thomasquinn93/gps-drifters/3D Models/Drifter Enclosure - SD Card Holder.stl

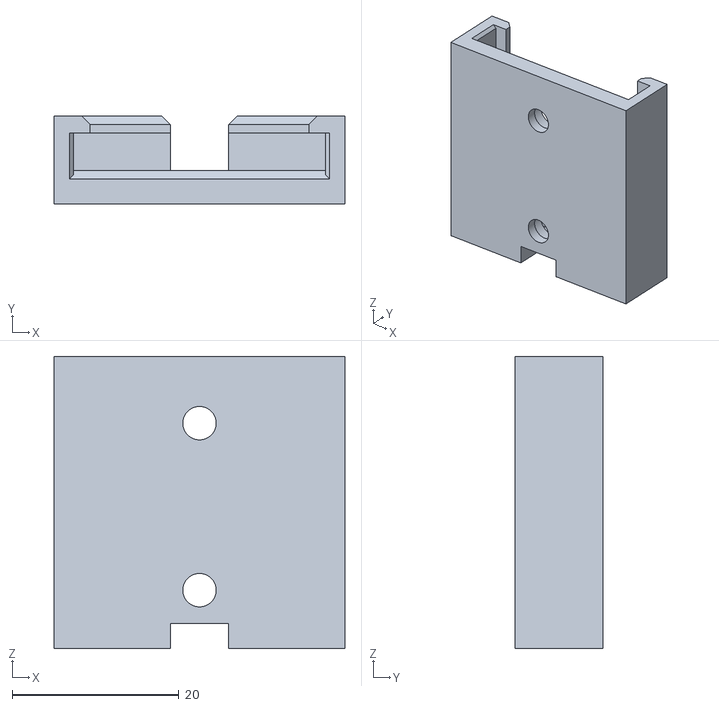
[picture p1: CAD file, 2018-05-13]
3D Models/Drifter Enclosure - SD Card Holder.stl
34.9 x 10.5 x 35.0
