thomasquinn93/gps-drifters/3D Models/Drifter Enclosure - o-ring.stl

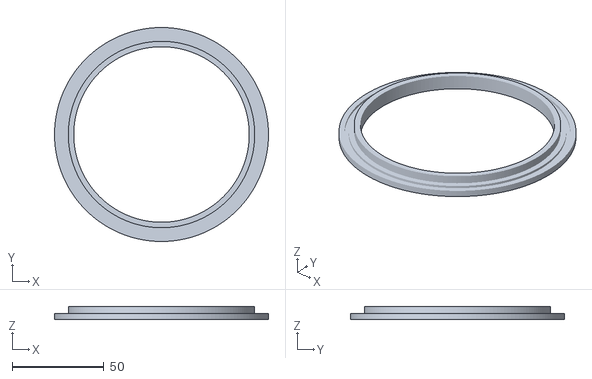
[picture p2: CAD file, 2018-05-13]
3D Models/Drifter Enclosure - o-ring.stl
116.9 x 116.9 x 7.25
