thomasquinn93/gps-drifters/3D Models/Drifter Enclosure - Bottom Left Wing.stl

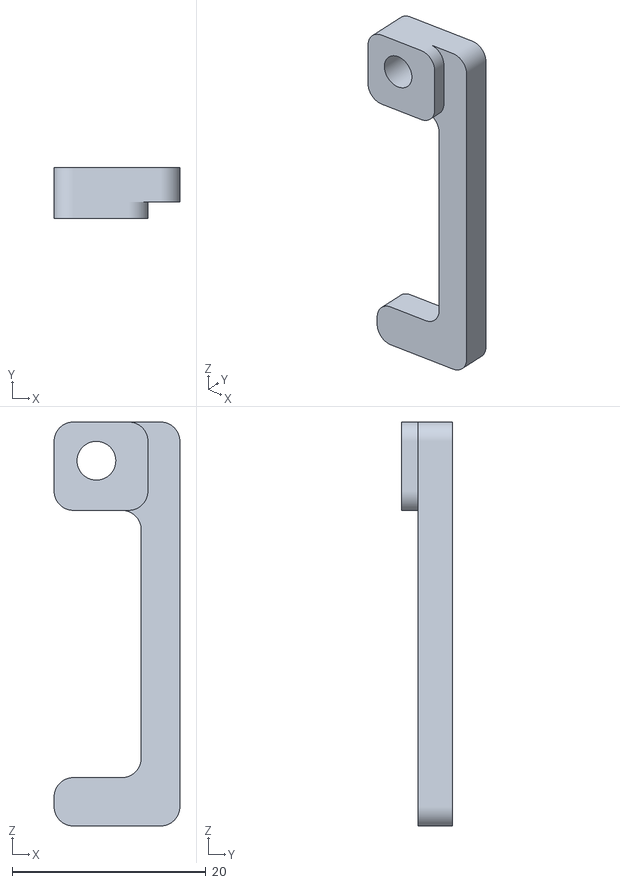
[picture p3: CAD file, 2018-05-13]
3D Models/Drifter Enclosure - Bottom Left Wing.stl
13.0 x 5.30 x 41.7
