thomasquinn93/gps-drifters/3D Models/Drifter Enclosure - Cradle.stl

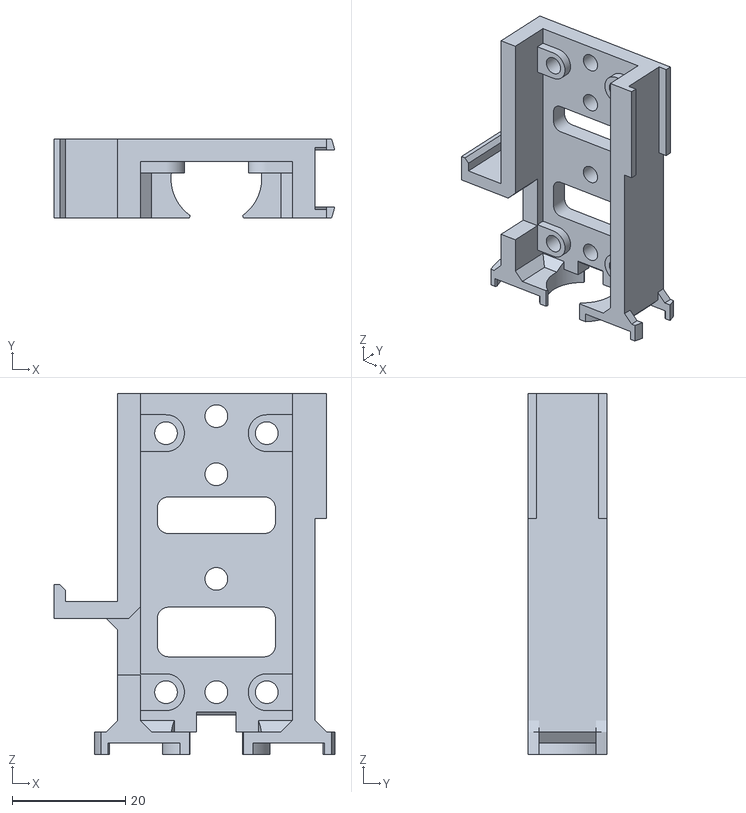
[picture p4: CAD file, 2018-05-13]
3D Models/Drifter Enclosure - Cradle.stl
49.5 x 14.0 x 63.7
