thomasquinn93/gps-drifters/3D Models/Drifter Enclosure - Base.stl

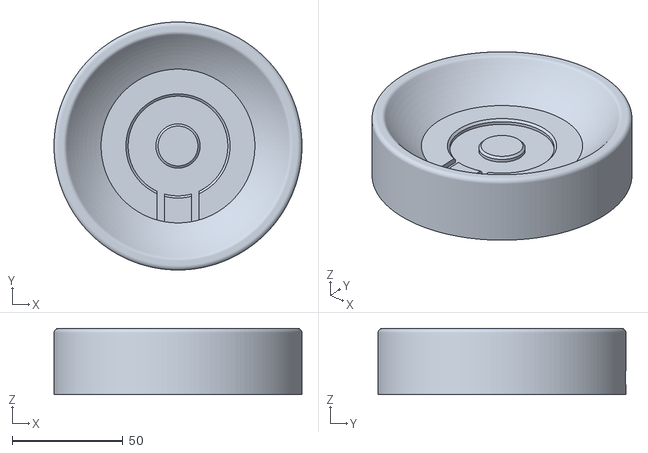
[picture p5: CAD file, 2018-05-13]
3D Models/Drifter Enclosure - Base.stl
112.0 x 112.0 x 29.9
