thomasquinn93/gps-drifters/3D Models/Drifter Enclosure - Shell Bottom.stl

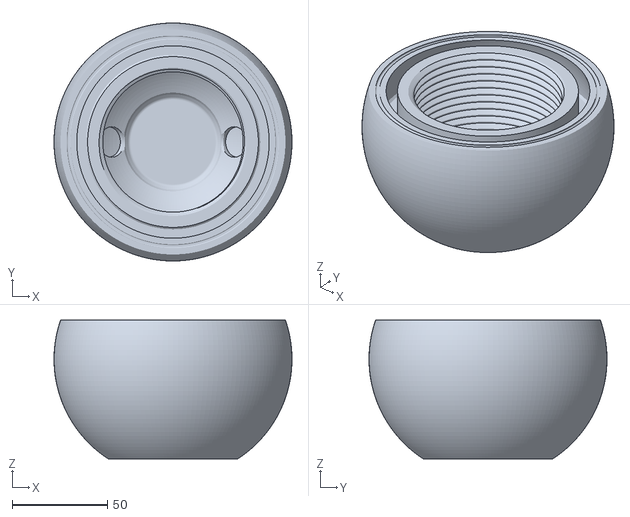
[picture p6: CAD file, 2018-05-13]
3D Models/Drifter Enclosure - Shell Bottom.stl
124.8 x 124.8 x 72.7
