thomasquinn93/gps-drifters/3D Models/Drifter Enclosure - Shell Top.stl

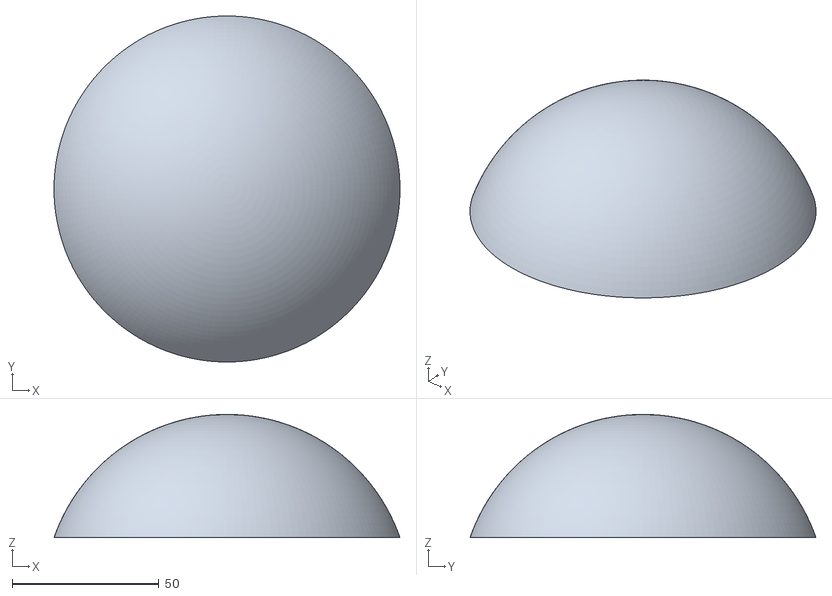
[picture p7: CAD file, 2018-05-13]
3D Models/Drifter Enclosure - Shell Top.stl
117.9 x 117.9 x 42.0
