thomasquinn93/gps-drifters/3D Models/Drifter Enclosure - Wing Connector.stl

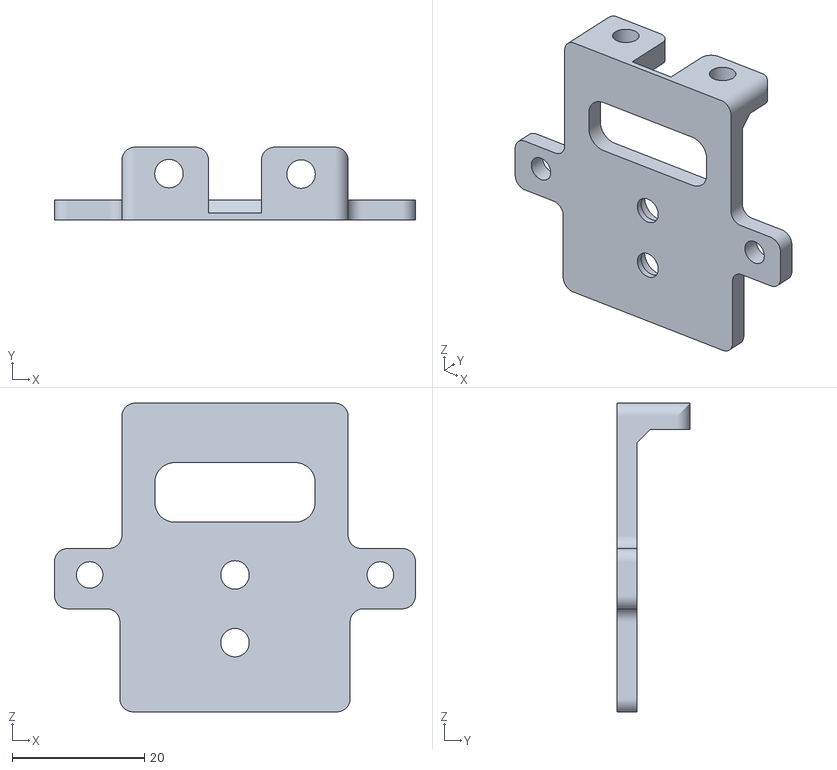
[picture p8: CAD file, 2018-05-13]
3D Models/Drifter Enclosure - Wing Connector.stl
54.6 x 11.0 x 46.7
