thomasquinn93/gps-drifters/3D Models/Drifter Enclosure - Shelf.stl

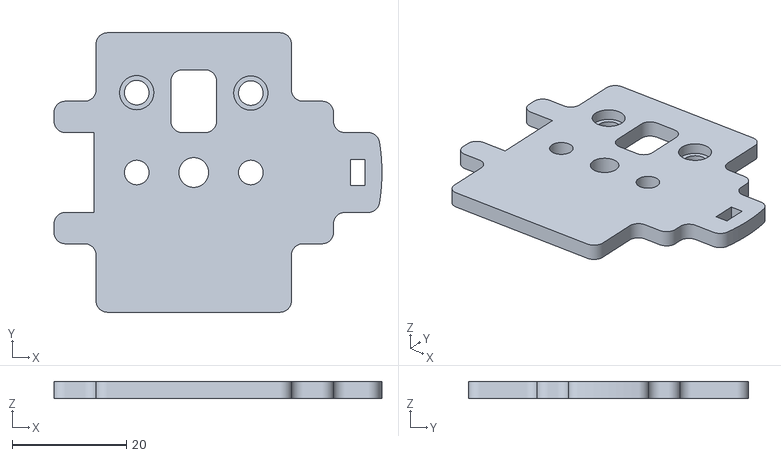
[picture p9: CAD file, 2018-05-13]
3D Models/Drifter Enclosure - Shelf.stl
57.5 x 49.0 x 3.00
