thomasquinn93/gps-drifters/3D Models/Drifter Enclosure - Core.stl

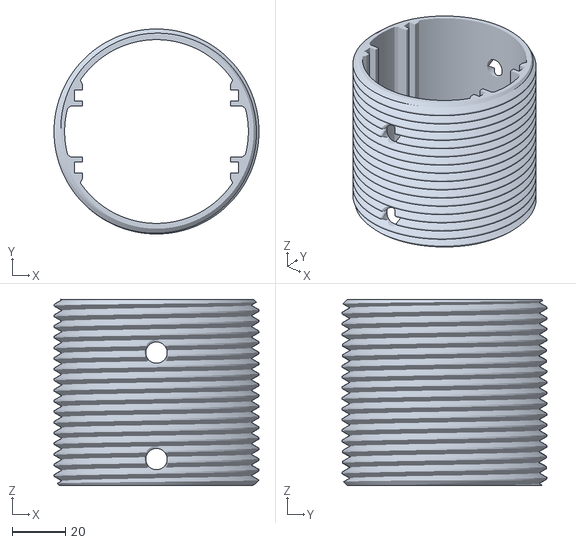
[picture p10: CAD file, 2018-05-13]
3D Models/Drifter Enclosure - Core.stl
77.0 x 77.0 x 70.0
