thomasquinn93/gps-drifters/(list of files, cad)

Other CAD files:
3D Models/Drifter Enclosure - Bottom Right Wing.stl
