thomasquinn93/gps-drifters/ultimateGPS-featherwing-test/ultimateGPS-featherwing-test.ino

// test a passthru between USB and hardware serial

#if defined(ARDUINO_SAMD_ZERO) && defined(SERIAL_PORT_USBVIRTUAL)
  // Required for Serial on Zero based boards
  #define Serial SERIAL_PORT_USBVIRTUAL
#endif

void setup() {
  Serial.println("GPS echo test");
  Serial.begin(9600);
  Serial1.begin(9600);      // default NMEA GPS baud
}


void loop() {
  if (Serial.available()) {
    char c = Serial.read();
    Serial1.write(c);
  }
  if (Serial1.available()) {
    char c = Serial1.read();
    Serial.write(c);
  }
}
