thomasquinn93/gps-drifters/(commit log)

2018-03-11 Blink test for Adafruit Feather HUZZAH with ESP8266 WiFi
    - Needed to test board was working.
2018-03-14 OLED FeatherWing Test
    - Testing of the Adafruit OLED FeatherWing board.
2018-04-11 Version v0.2
    - Added GPS module but found bug that doesn't update screen.
    [basic-logger.ino]
2018-04-11 Version v1.0
    - Due to compatability issues with the feather boards developments was moved to standard breakout boards.
    - This "Nano Data Logger" can log data from a gps module to an SD, display status and errors on an RGB LED and incorporates a debounced button to start/stop recordings.
    [nano-basic-logger.ino]
2018-04-21 GPS Drifter Version 1.00.00
    - RGB class written with both analog and digital outs.
    - Button class written with 3 states, none, short or long press.
    - Buzzer class written with startup tone.
    [Button.cpp, Button.h, Buzzer.cpp, Buzzer.h, RGBled.cpp, RGBled.h, gps-drifters.ino]
2018-04-23 Version 1.01.00
    - Added flash function to RGB class.
    - Idle mode added (ready to log).
    - Live mode added (print information to serial port).
    - Added battery class.
2018-04-23 GPS Drifter Version 1.02.00
    - Added fade to RGB class.
    - Added charge detect function to battery class.
    - RGB fades when charging.
    [Battery.cpp, RGBled.cpp, RGBled.h, gps-drifters.ino]
2018-04-23 GPS Drifters 1.03.00
    - Started GPS class.
    [QuinnGPS.cpp, QuinnGPS.h, gps-drifters.ino]
2018-04-24 GPS Drifters 1.04.00
    - Finished GPS class.
    [QuinnGPS.cpp, QuinnGPS.h, gps-drifters.ino]
2018-04-25 GPS Drifter v1.05.00
    - Wrote SD class.
    - Data saves to file.
    [QuinnGPS.cpp, QuinnGPS.h, QuinnSD.cpp, QuinnSD.h, gps-drifters.ino]
2018-04-27 GPS Drifter 1.06.00
    - Created Hall Effect sensor class (Same as button class).
    - Added hall effect sensor to act as button.
    [Buzzer.cpp, Buzzer.h, Hall.cpp, Hall.h, gps-drifters.ino]
2018-04-28 GPS Drifter 1.07.00
    - Added error states. 1 = White (no gps fix), 2 = Cyan (SD failed to initalise), 3 = Magenta (battery error).
    [Battery.cpp, QuinnGPS.cpp, gps-drifters.ino]
2018-04-30 GPS Drifter 1.07.01
    - Changed charging constant from 4.6v to 4.4v.
    [Battery.cpp, gps-drifters.ino]
2018-04-30 GPS Drifter 1.07.02
    - Reverted charging constant to 4.6v.
    - Changed overcharge voltage from MAX*1.05 to MAX*1.06.
    [Battery.cpp, gps-drifters.ino]
2018-05-06 GPS Drifter 1.08.00
    - Added battery voltage data saved to SD card.
    - Suppressed buzzer when logging for battery life testing.
    [QuinnSD.cpp, gps-drifters.ino]
2018-05-09 GPS Drifter 1.09.00
    - Changed minimum battery voltage to 3.7v before error is
    displayed due to voltage required for FlashAir SD card.
    - Changed min charge detect voltage to 4.4V.
    - Unsuppressed buzzer when logging.
    - Fixed the white LED no fix bug.
    [Battery.cpp, gps-drifters.ino]
2018-05-10 GPS Drifters v2.00.00
    - Added feature to load data from config file (log while charging,
    and Sample rate).
    [QuinnSD.cpp, QuinnSD.h, gps-drifters.ino]
2018-05-10 GPS Drifter 2.00.01
    - Removed printing of log while charging status and sample rate to serial port.
    [gps-drifters.ino]
2018-05-13 GPS Drifters 2.00.01
    - Reduced charging voltage indicator to 4.25v.
    - Added extra comments.
    [Battery.cpp, gps-drifters.ino]
2018-05-13 GPS Drifters 2.00.02
    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
    [Battery.cpp, gps-drifters.ino]
2018-05-13 Added LabVIEW Code
    - Added LabVIEW code of PC interface.
    [config.txt, drifter_mac_addresses.CSV]
2018-05-13 Added 3D Models
    - Added all project 3D models ready to print.
    [Drifter Enclosure - Base.stl, Drifter Enclosure - Bottom Left Wing.stl, Drifter Enclosure - Bottom Right Wing.stl, Drifter Enclosure - Core.stl, Drifter Enclosure - Cradle.stl, Drifter Enclosure - SD Card Holder.stl, Drifter Enclosure - Shelf.stl, Drifter Enclosure - Shell Bottom.stl]
